takeyamayuki/crkbd/plates/common/top3.dxf

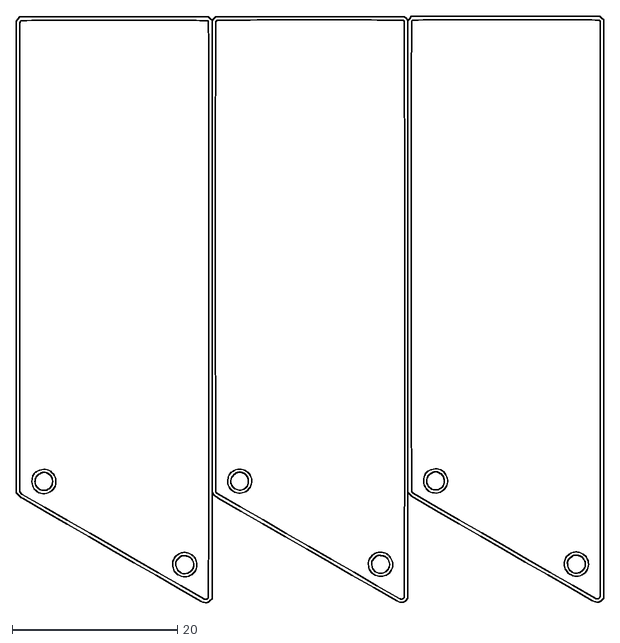
[picture p17: CAD file, 2023-07-30]
plates/common/top3.dxf
71.1 x 71.0
