takeyamayuki/crkbd/plates/common/top2.dxf

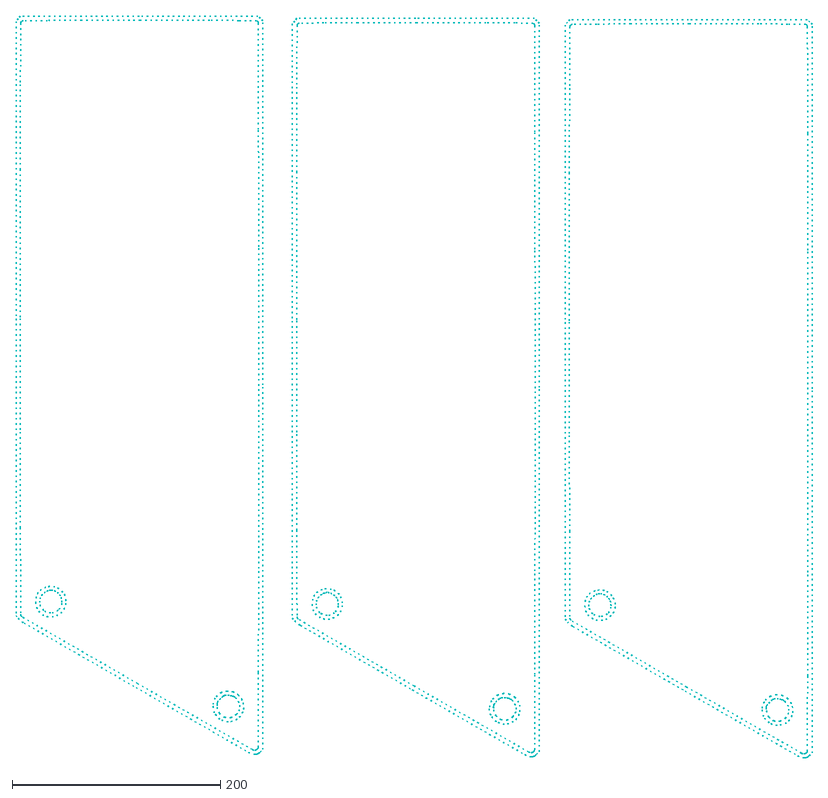
[picture p18: CAD file, 2023-07-28]
plates/common/top2.dxf
764.3 x 712.3
