takeyamayuki/crkbd/plates/common/top.dxf

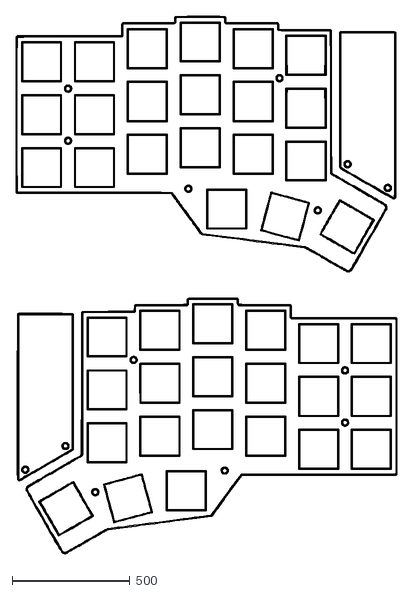
[picture p19: CAD file, 2023-07-21]
plates/common/top.dxf
1616.8 x 2279.6
