takeyamayuki/crkbd/(list of files, cad)

Other CAD files:
plates/common/top3.dwg
