takeyamayuki/crkbd/corne-cherry/pcb/corne-cherry.kicad_pcb

## KiCad design corne-cherry/pcb/corne-cherry.kicad_pcb (2022-05-05)

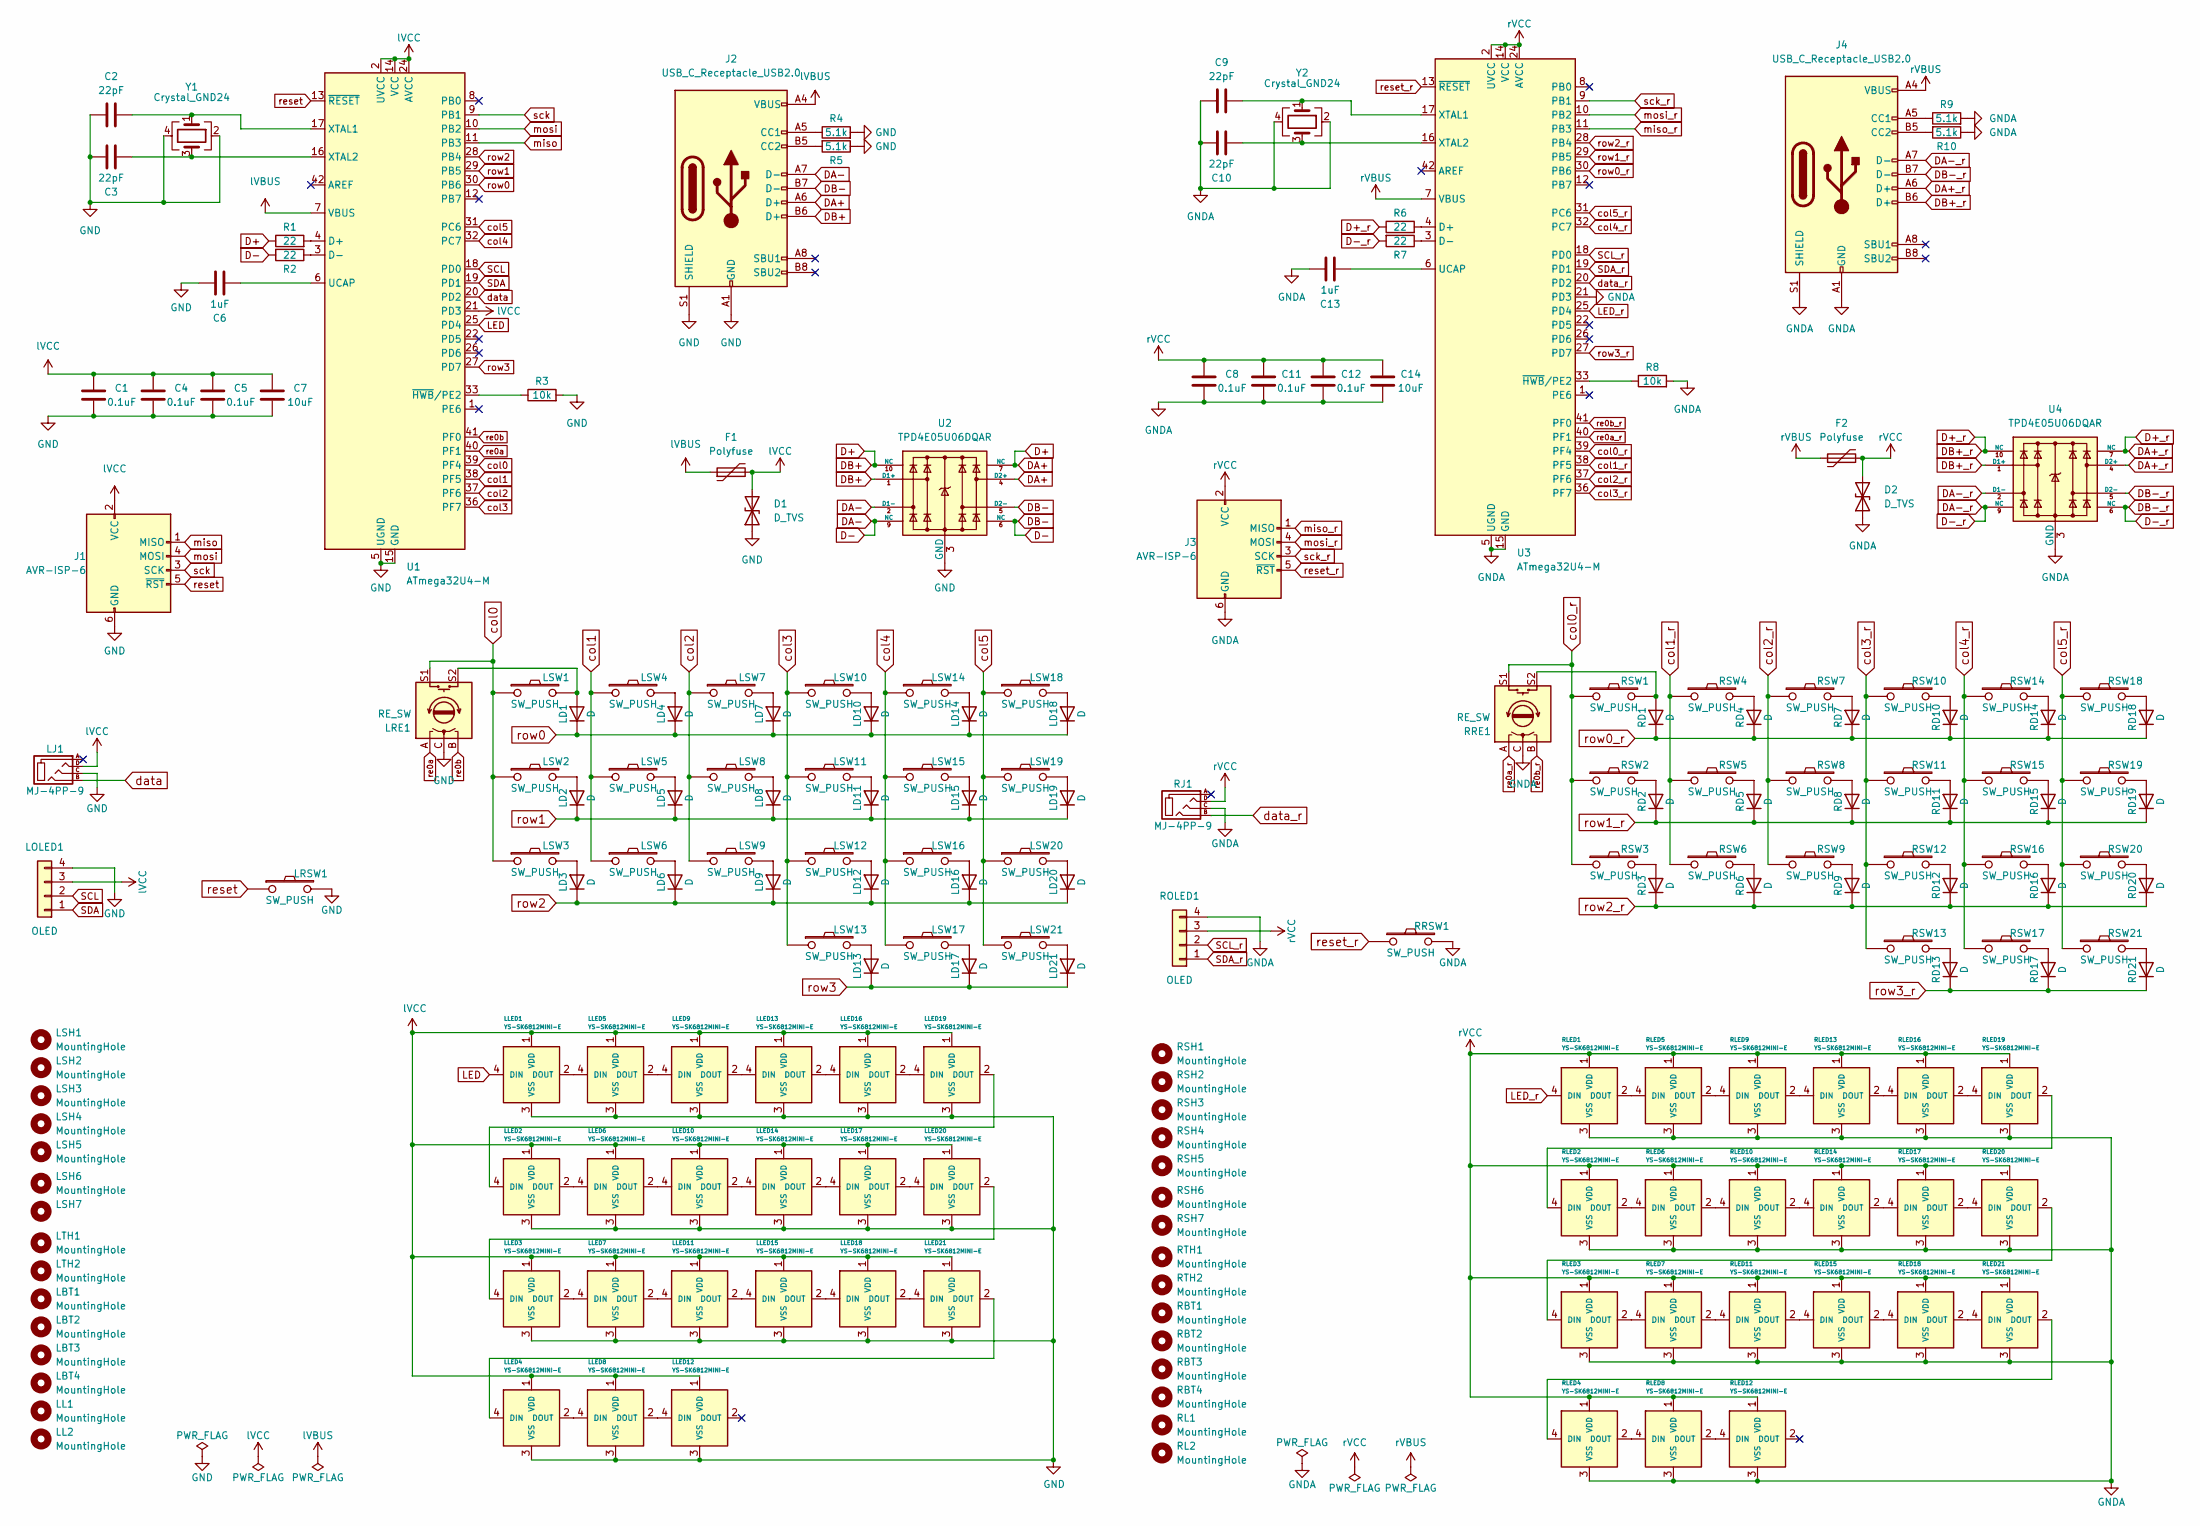
[picture p20: schematic corne-cherry.kicad_sch, Corne]

Parts:
C1, C4, C5, C8, C11, C12: 0.1uF; C_0603_1608Metric
C2, C3, C9, C10: 22pF; C_0603_1608Metric
C6, C13: 1uF; C_0603_1608Metric
C7, C14: 10uF; C_0603_1608Metric
D1, D2: D_TVS; D_SOD-123
F1, F2: Polyfuse; Fuse_1206_3216Metric
J1, J3: AVR-ISP-6
J2, J4: USB_C_Receptacle_USB2.0; USB_C_Receptacle_HRO_TYPE-C-31-M-12
LBT1, LBT2, LBT3, LBT4: MountingHole; Breakaway_Tabs
LD1, LD2, LD3, LD4, LD5, LD6, LD7, LD8, LD9, LD10, LD11, LD12, LD13, LD14, LD15, LD16, LD17, LD18, LD19, LD20, LD21: D; D3_SMD_v2
LJ1: MJ-4PP-9; MJ-4PP-9_1side
LL1, LL2: MountingHole; corne-logo-horizontal
LLED1, LLED2, LLED3, LLED4, LLED5, LLED6, LLED7, LLED8, LLED9, LLED10, LLED11, LLED12, LLED13, LLED14, LLED15, LLED16, LLED17, LLED18, LLED19, LLED20, LLED21: YS-SK6812MINI-E
LOLED1: OLED; OLED_1side
LRE1: RE_SW; RotaryEncoder_EC12-SW
LRSW1: SW_PUSH; ResetSW
LSH1, LSH2, LSH3, LSH4, LSH5, LSH6: MountingHole; spacer_m2
LSH7: (no value)
LSW1, LSW2, LSW3, LSW4, LSW5, LSW6, LSW7, LSW8, LSW9, LSW10, LSW11, LSW12, LSW13, LSW14, LSW15, LSW16, LSW17, LSW18, LSW19, LSW20: SW_PUSH; CherryMX_Hotswap
LSW21: SW_PUSH; CherryMX_Hotswap_1.5u
LTH1, LTH2: MountingHole; thread_m2
R1, R2, R6, R7: 22; R_0603_1608Metric
R3, R8: 10k; R_0603_1608Metric
R4, R5, R9, R10: 5.1k; R_0603_1608Metric
RBT1, RBT2, RBT3, RBT4: MountingHole; Breakaway_Tabs
RD1, RD2, RD3, RD4, RD5, RD6, RD7, RD8, RD9, RD10, RD11, RD12, RD13, RD14, RD15, RD16, RD17, RD18, RD19, RD20, RD21: D; D3_SMD_v2
RJ1: MJ-4PP-9; MJ-4PP-9_1side
RL1, RL2: MountingHole; corne-logo-horizontal
RLED1, RLED2, RLED3, RLED4, RLED5, RLED6, RLED7, RLED8, RLED9, RLED10, RLED11, RLED12, RLED13, RLED14, RLED15, RLED16, RLED17, RLED18, RLED19, RLED20, RLED21: YS-SK6812MINI-E
ROLED1: OLED; OLED_1side
RRE1: RE_SW; RotaryEncoder_EC12-SW
RRSW1: SW_PUSH; ResetSW
RSH1, RSH2, RSH3, RSH4, RSH5, RSH6, RSH7: MountingHole; spacer_m2
RSW1, RSW2, RSW3, RSW4, RSW5, RSW6, RSW7, RSW8, RSW9, RSW10, RSW11, RSW12, RSW13, RSW14, RSW15, RSW16, RSW17, RSW18, RSW19, RSW20: SW_PUSH; CherryMX_Hotswap
RSW21: SW_PUSH; CherryMX_Hotswap_1.5u
RTH1, RTH2: MountingHole; thread_m2
U1, U3: ATmega32U4-M; QFN-44-1EP_7x7mm_P0.5mm_EP5.2x5.2mm
U2, U4: TPD4E05U06DQAR; USON-10_2.5x1.0mm_P0.5mm
Y1, Y2: Crystal_GND24; Crystal_SMD_3225-4Pin_3.2x2.5mm

Connections:
D+: J2.A6 (D+), J2.B6 (D+), R1.1, U2.1 (D1+), U2.4 (D2+), U2.7 (NC), U2.10 (NC)
D+_r: J4.A6 (D+), J4.B6 (D+), R6.1, U4.1 (D1+), U4.4 (D2+), U4.7 (NC), U4.10 (NC)
D-: J2.A7 (D-), J2.B7 (D-), R2.2, U2.2 (D1-), U2.5 (D2-), U2.6 (NC), U2.9 (NC)
D-_r: J4.A7 (D-), J4.B7 (D-), R7.2, U4.2 (D1-), U4.5 (D2-), U4.6 (NC), U4.9 (NC)
GND: C1.1, C2.1, C3.1, C4.1, C5.1, C6.1, C7.1, D1.1 (A1), J1.6 (GND), J2.A1 (GND), J2.A12 (GND), J2.B1 (GND), J2.B12 (GND), J2.S1 (SHIELD), LJ1.C, LLED1.3 (VSS), LLED2.3 (VSS), LLED3.3 (VSS), LLED4.3 (VSS), LLED5.3 (VSS), LLED6.3 (VSS), LLED7.3 (VSS), LLED8.3 (VSS), LLED9.3 (VSS), LLED10.3 (VSS), LLED11.3 (VSS), LLED12.3 (VSS), LLED13.3 (VSS), LLED14.3 (VSS), LLED15.3 (VSS), LLED16.3 (VSS), LLED17.3 (VSS), LLED18.3 (VSS), LLED19.3 (VSS), LLED20.3 (VSS), LLED21.3 (VSS), LOLED1.4, LRE1.C, LRSW1.2, R3.2, R4.2, R5.1, U1.5 (UGND), U1.15 (GND), U1.23 (GND), U1.35 (GND), U1.43 (GND), U1.45 (GND), U2.3 (GND), U2.8 (GND), Y1.2, Y1.4
GNDA: C8.1, C9.1, C10.1, C11.1, C12.1, C13.1, C14.1, D2.1 (A1), J3.6 (GND), J4.A1 (GND), J4.A12 (GND), J4.B1 (GND), J4.B12 (GND), J4.S1 (SHIELD), R8.2, R9.2, R10.1, RJ1.C, RLED1.3 (VSS), RLED2.3 (VSS), RLED3.3 (VSS), RLED4.3 (VSS), RLED5.3 (VSS), RLED6.3 (VSS), RLED7.3 (VSS), RLED8.3 (VSS), RLED9.3 (VSS), RLED10.3 (VSS), RLED11.3 (VSS), RLED12.3 (VSS), RLED13.3 (VSS), RLED14.3 (VSS), RLED15.3 (VSS), RLED16.3 (VSS), RLED17.3 (VSS), RLED18.3 (VSS), RLED19.3 (VSS), RLED20.3 (VSS), RLED21.3 (VSS), ROLED1.4, RRE1.C, RRSW1.2, U3.5 (UGND), U3.15 (GND), U3.21 (PD3), U3.23 (GND), U3.35 (GND), U3.43 (GND), U3.45 (GND), U4.3 (GND), U4.8 (GND), Y2.2, Y2.4
LED: LLED1.4 (DIN), U1.25 (PD4)
LED_r: RLED1.4 (DIN), U3.25 (PD4)
unnamed: C2.2, U1.17 (XTAL1), Y1.1
unnamed: C3.2, U1.16 (XTAL2), Y1.3
unnamed: C6.2, U1.6 (UCAP)
unnamed: C9.2, U3.17 (XTAL1), Y2.1
unnamed: C10.2, U3.16 (XTAL2), Y2.3
unnamed: C13.2, U3.6 (UCAP)
unnamed: J2.A5 (CC1), R4.1
unnamed: J2.B5 (CC2), R5.2
unnamed: J4.A5 (CC1), R9.1
unnamed: J4.B5 (CC2), R10.2
unnamed: LD1.2 (A), LRE1.S2, LSW1.2
unnamed: LD2.2 (A), LSW2.2
unnamed: LD3.2 (A), LSW3.2
unnamed: LD4.2 (A), LSW4.2
unnamed: LD5.2 (A), LSW5.2
unnamed: LD6.2 (A), LSW6.2
unnamed: LD7.2 (A), LSW7.2
unnamed: LD8.2 (A), LSW8.2
unnamed: LD9.2 (A), LSW9.2
unnamed: LD10.2 (A), LSW10.2
unnamed: LD11.2 (A), LSW11.2
unnamed: LD12.2 (A), LSW12.2
unnamed: LD13.2 (A), LSW13.2
unnamed: LD14.2 (A), LSW14.2
unnamed: LD15.2 (A), LSW15.2
unnamed: LD16.2 (A), LSW16.2
unnamed: LD17.2 (A), LSW17.2
unnamed: LD18.2 (A), LSW18.2
unnamed: LD19.2 (A), LSW19.2
unnamed: LD20.2 (A), LSW20.2
unnamed: LD21.2 (A), LSW21.2
unnamed: LLED1.2 (DOUT), LLED5.4 (DIN)
unnamed: LLED2.2 (DOUT), LLED6.4 (DIN)
unnamed: LLED3.2 (DOUT), LLED7.4 (DIN)
unnamed: LLED4.2 (DOUT), LLED8.4 (DIN)
unnamed: LLED5.2 (DOUT), LLED9.4 (DIN)
unnamed: LLED10.2 (DOUT), LLED14.4 (DIN)
unnamed: LLED6.2 (DOUT), LLED10.4 (DIN)
unnamed: LLED11.2 (DOUT), LLED15.4 (DIN)
unnamed: LLED7.2 (DOUT), LLED11.4 (DIN)
unnamed: LLED8.2 (DOUT), LLED12.4 (DIN)
unnamed: LLED13.2 (DOUT), LLED16.4 (DIN)
unnamed: LLED9.2 (DOUT), LLED13.4 (DIN)
unnamed: LLED14.2 (DOUT), LLED17.4 (DIN)
unnamed: LLED15.2 (DOUT), LLED18.4 (DIN)
unnamed: LLED16.2 (DOUT), LLED19.4 (DIN)
unnamed: LLED17.2 (DOUT), LLED20.4 (DIN)
unnamed: LLED18.2 (DOUT), LLED21.4 (DIN)
unnamed: LLED2.4 (DIN), LLED19.2 (DOUT)
unnamed: LLED3.4 (DIN), LLED20.2 (DOUT)
unnamed: LLED4.4 (DIN), LLED21.2 (DOUT)
unnamed: R1.2, U1.4 (D+)
unnamed: R2.1, U1.3 (D-)
unnamed: R3.1, U1.33 (~HWB/PE2)
unnamed: R6.2, U3.4 (D+)
unnamed: R7.1, U3.3 (D-)
unnamed: R8.1, U3.33 (~HWB/PE2)
unnamed: RD1.2 (A), RRE1.S2, RSW1.2
unnamed: RD2.2 (A), RSW2.2
unnamed: RD3.2 (A), RSW3.2
unnamed: RD4.2 (A), RSW4.2
unnamed: RD5.2 (A), RSW5.2
unnamed: RD6.2 (A), RSW6.2
unnamed: RD7.2 (A), RSW7.2
unnamed: RD8.2 (A), RSW8.2
unnamed: RD9.2 (A), RSW9.2
unnamed: RD10.2 (A), RSW10.2
unnamed: RD11.2 (A), RSW11.2
unnamed: RD12.2 (A), RSW12.2
unnamed: RD13.2 (A), RSW13.2
unnamed: RD14.2 (A), RSW14.2
unnamed: RD15.2 (A), RSW15.2
unnamed: RD16.2 (A), RSW16.2
unnamed: RD17.2 (A), RSW17.2
unnamed: RD18.2 (A), RSW18.2
unnamed: RD19.2 (A), RSW19.2
unnamed: RD20.2 (A), RSW20.2
unnamed: RD21.2 (A), RSW21.2
unnamed: RLED1.2 (DOUT), RLED5.4 (DIN)
unnamed: RLED2.2 (DOUT), RLED6.4 (DIN)
unnamed: RLED3.2 (DOUT), RLED7.4 (DIN)
unnamed: RLED4.2 (DOUT), RLED8.4 (DIN)
unnamed: RLED5.2 (DOUT), RLED9.4 (DIN)
unnamed: RLED10.2 (DOUT), RLED14.4 (DIN)
unnamed: RLED6.2 (DOUT), RLED10.4 (DIN)
unnamed: RLED11.2 (DOUT), RLED15.4 (DIN)
unnamed: RLED7.2 (DOUT), RLED11.4 (DIN)
unnamed: RLED8.2 (DOUT), RLED12.4 (DIN)
unnamed: RLED13.2 (DOUT), RLED16.4 (DIN)
unnamed: RLED9.2 (DOUT), RLED13.4 (DIN)
unnamed: RLED14.2 (DOUT), RLED17.4 (DIN)
unnamed: RLED15.2 (DOUT), RLED18.4 (DIN)
unnamed: RLED16.2 (DOUT), RLED19.4 (DIN)
unnamed: RLED17.2 (DOUT), RLED20.4 (DIN)
unnamed: RLED18.2 (DOUT), RLED21.4 (DIN)
unnamed: RLED2.4 (DIN), RLED19.2 (DOUT)
unnamed: RLED3.4 (DIN), RLED20.2 (DOUT)
unnamed: RLED4.4 (DIN), RLED21.2 (DOUT)
SCL: LOLED1.2, U1.18 (PD0)
SCL_r: ROLED1.2, U3.18 (PD0)
SDA: LOLED1.1, U1.19 (PD1)
SDA_r: ROLED1.1, U3.19 (PD1)
col0: LRE1.S1, LSW1.1, LSW2.1, LSW3.1, U1.39 (PF4)
col0_r: RRE1.S1, RSW1.1, RSW2.1, RSW3.1, U3.39 (PF4)
col1: LSW4.1, LSW5.1, LSW6.1, U1.38 (PF5)
col1_r: RSW4.1, RSW5.1, RSW6.1, U3.38 (PF5)
col2: LSW7.1, LSW8.1, LSW9.1, U1.37 (PF6)
col2_r: RSW7.1, RSW8.1, RSW9.1, U3.37 (PF6)
col3: LSW10.1, LSW11.1, LSW12.1, LSW13.1, U1.36 (PF7)
col3_r: RSW10.1, RSW11.1, RSW12.1, RSW13.1, U3.36 (PF7)
col4: LSW14.1, LSW15.1, LSW16.1, LSW17.1, U1.32 (PC7)
col4_r: RSW14.1, RSW15.1, RSW16.1, RSW17.1, U3.32 (PC7)
col5: LSW18.1, LSW19.1, LSW20.1, LSW21.1, U1.31 (PC6)
col5_r: RSW18.1, RSW19.1, RSW20.1, RSW21.1, U3.31 (PC6)
data: LJ1.B, U1.20 (PD2)
data_r: RJ1.B, U3.20 (PD2)
lVBUS: F1.1, J2.A4 (VBUS), J2.A9 (VBUS), J2.B4 (VBUS), J2.B9 (VBUS), U1.7 (VBUS)
lVCC: C1.2, C4.2, C5.2, C7.2, D1.2 (A2), F1.2, J1.2 (VCC), LJ1.D, LLED1.1 (VDD), LLED2.1 (VDD), LLED3.1 (VDD), LLED4.1 (VDD), LLED5.1 (VDD), LLED6.1 (VDD), LLED7.1 (VDD), LLED8.1 (VDD), LLED9.1 (VDD), LLED10.1 (VDD), LLED11.1 (VDD), LLED12.1 (VDD), LLED13.1 (VDD), LLED14.1 (VDD), LLED15.1 (VDD), LLED16.1 (VDD), LLED17.1 (VDD), LLED18.1 (VDD), LLED19.1 (VDD), LLED20.1 (VDD), LLED21.1 (VDD), LOLED1.3, U1.2 (UVCC), U1.14 (VCC), U1.21 (PD3), U1.24 (AVCC), U1.34 (VCC), U1.44 (AVCC)
miso: J1.1 (MISO), U1.11 (PB3)
miso_r: J3.1 (MISO), U3.11 (PB3)
mosi: J1.4 (MOSI), U1.10 (PB2)
mosi_r: J3.4 (MOSI), U3.10 (PB2)
rVBUS: F2.1, J4.A4 (VBUS), J4.A9 (VBUS), J4.B4 (VBUS), J4.B9 (VBUS), U3.7 (VBUS)
rVCC: C8.2, C11.2, C12.2, C14.2, D2.2 (A2), F2.2, J3.2 (VCC), RJ1.D, RLED1.1 (VDD), RLED2.1 (VDD), RLED3.1 (VDD), RLED4.1 (VDD), RLED5.1 (VDD), RLED6.1 (VDD), RLED7.1 (VDD), RLED8.1 (VDD), RLED9.1 (VDD), RLED10.1 (VDD), RLED11.1 (VDD), RLED12.1 (VDD), RLED13.1 (VDD), RLED14.1 (VDD), RLED15.1 (VDD), RLED16.1 (VDD), RLED17.1 (VDD), RLED18.1 (VDD), RLED19.1 (VDD), RLED20.1 (VDD), RLED21.1 (VDD), ROLED1.3, U3.2 (UVCC), U3.14 (VCC), U3.24 (AVCC), U3.34 (VCC), U3.44 (AVCC)
re0a: LRE1.A, U1.40 (PF1)
re0a_r: RRE1.A, U3.40 (PF1)
re0b: LRE1.B, U1.41 (PF0)
re0b_r: RRE1.B, U3.41 (PF0)
reset: J1.5 (~RST), LRSW1.1, U1.13 (~RESET)
reset_r: J3.5 (~RST), RRSW1.1, U3.13 (~RESET)
row0: LD1.1 (K), LD4.1 (K), LD7.1 (K), LD10.1 (K), LD14.1 (K), LD18.1 (K), U1.30 (PB6)
row0_r: RD1.1 (K), RD4.1 (K), RD7.1 (K), RD10.1 (K), RD14.1 (K), RD18.1 (K), U3.30 (PB6)
row1: LD2.1 (K), LD5.1 (K), LD8.1 (K), LD11.1 (K), LD15.1 (K), LD19.1 (K), U1.29 (PB5)
row1_r: RD2.1 (K), RD5.1 (K), RD8.1 (K), RD11.1 (K), RD15.1 (K), RD19.1 (K), U3.29 (PB5)
row2: LD3.1 (K), LD6.1 (K), LD9.1 (K), LD12.1 (K), LD16.1 (K), LD20.1 (K), U1.28 (PB4)
row2_r: RD3.1 (K), RD6.1 (K), RD9.1 (K), RD12.1 (K), RD16.1 (K), RD20.1 (K), U3.28 (PB4)
row3: LD13.1 (K), LD17.1 (K), LD21.1 (K), U1.27 (PD7)
row3_r: RD13.1 (K), RD17.1 (K), RD21.1 (K), U3.27 (PD7)
sck: J1.3 (SCK), U1.9 (PB1)
sck_r: J3.3 (SCK), U3.9 (PB1)

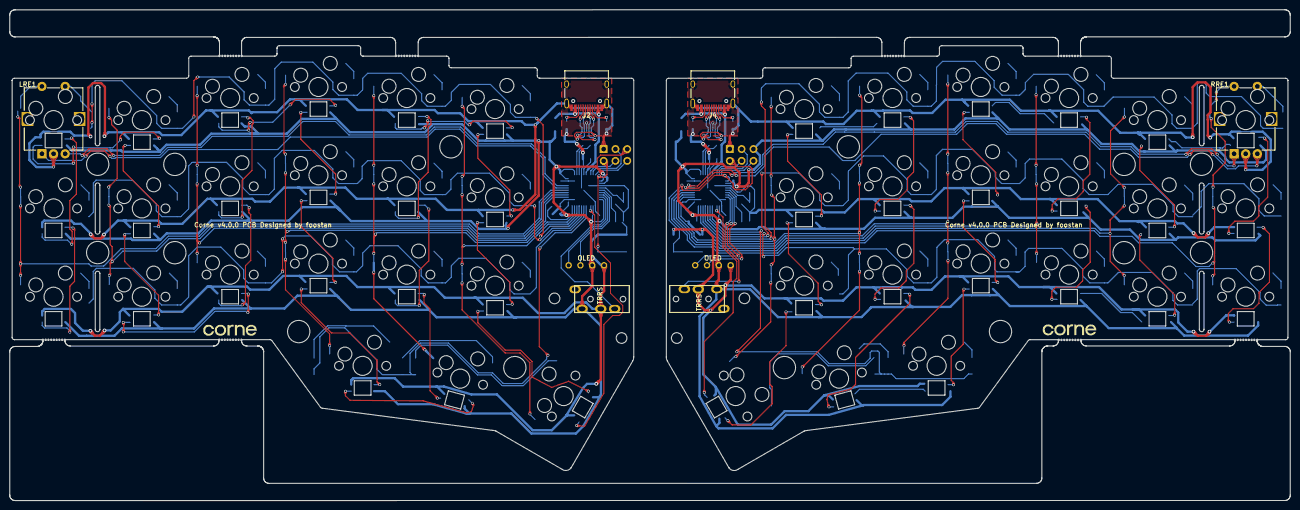
[picture p21: board corne-cherry.kicad_pcb from above]

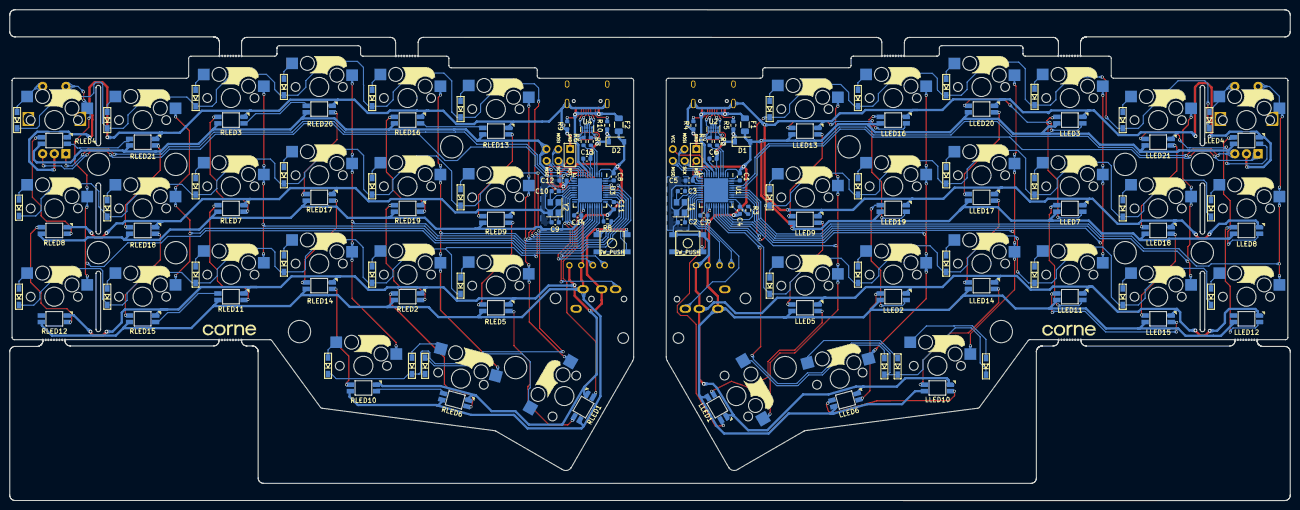
[picture p22: board corne-cherry.kicad_pcb from below]

Board: 2 copper layers, 275.5 x 105.6 mm, 202 parts (124 on the bottom side), 146 nets.
