takeyamayuki/crkbd/(commit log)

2022-05-05 Update for v4
    [corne-cherry.kicad_pcb, corne-cherry.kicad_sch]
2023-07-21 add elecrow dxf
    [top.dxf]
2023-07-28 add 100mm * 100mm
    [top2.dxf]
2023-07-30 add ver3
    [top3.dwg, top3.dxf]
